azlan-works/Kestrel-15/README.md

# Kestrel-15: An Opensource FPGA SoM based on the Gowin GW5AT-15

1mm JLCPCB 6-layer 7628 stackup:
