azlan-works/Kestrel-15/Kestrel-15.kicad_pcb

## KiCad design Kestrel-15.kicad_pcb (2026-10-23)

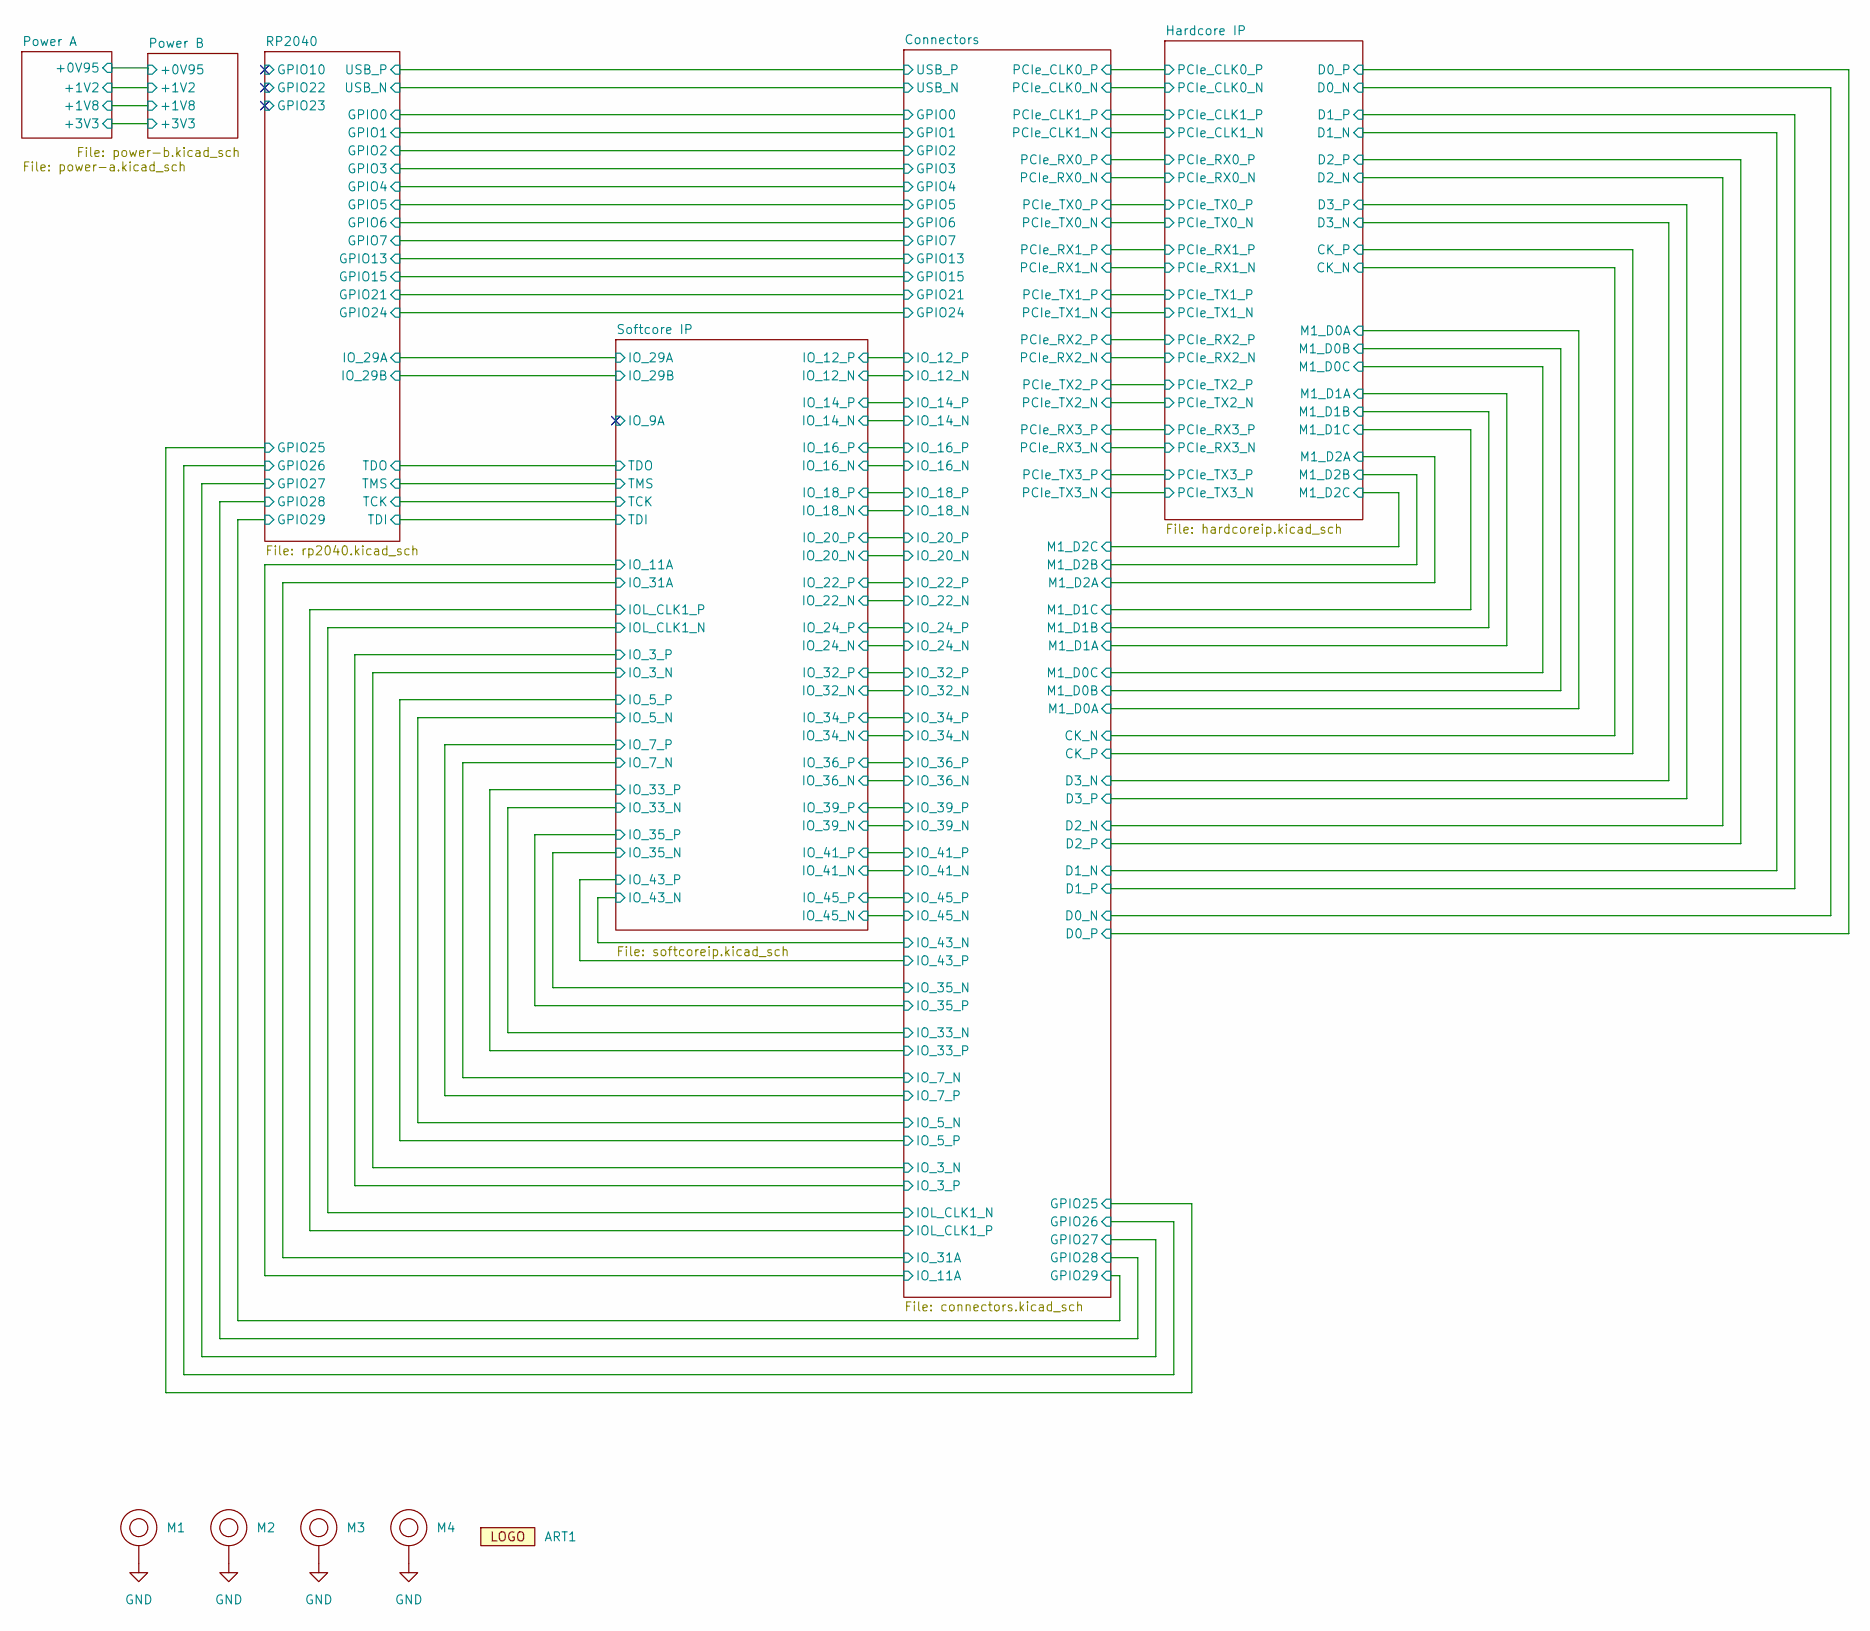
[picture p1: schematic Kestrel-15.kicad_sch]

Parts:
ART1: azlan.works_logo
M1, M2, M3, M4: M2_Hole

Connections:
GND: M1.1 (1_1), M2.1 (1_1), M3.1 (1_1), M4.1 (1_1); also elsewhere on the board

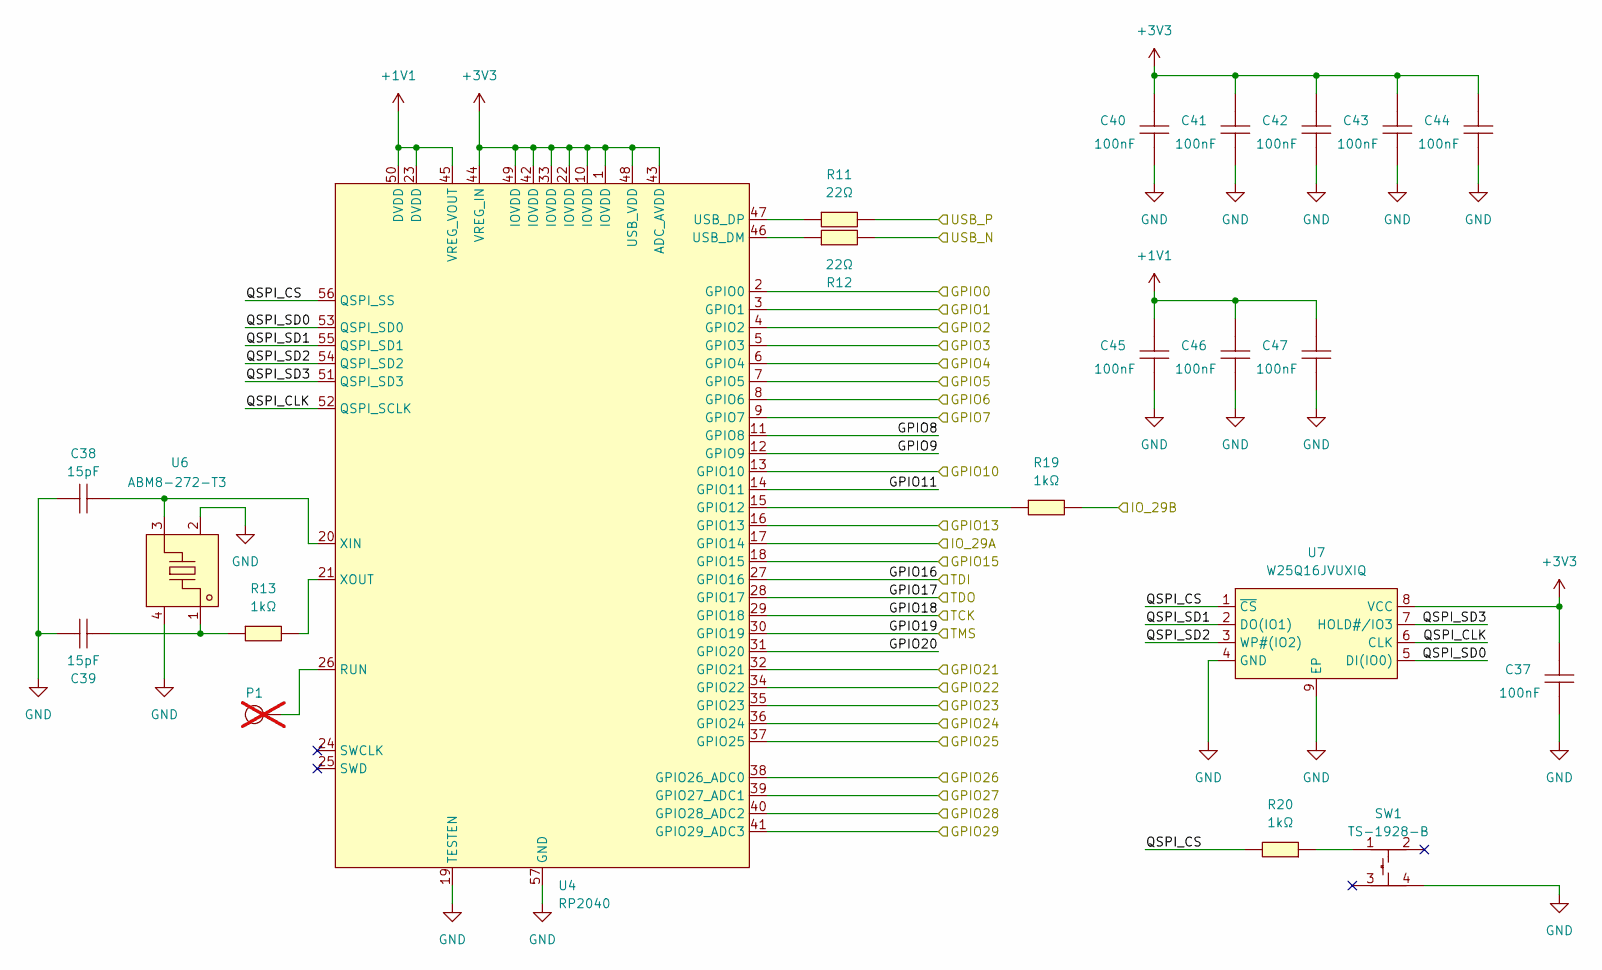
[picture p2: schematic rp2040.kicad_sch, Kestrel-15]

Parts:
C37, C40, C41, C42, C43, C44, C45, C46, C47: 100nF; C0201; MPN 0201X104M250NT; LCSC Part C52033358
C38, C39: 15pF; C0402; MPN 0402CG150J500NT; LCSC Part C1548
P1: Pogo Pin; TESTPOINT-SMD_BD2.0_C9900030651; MPN YTC1P-3010-01; LCSC Part C5221282; not fitted
R11, R12: 22Ω; R0402; MPN 0402WGF220JTCE; LCSC Part C25092
R13, R19, R20: 1kΩ; R0201; MPN 0201WMF1001TEE; LCSC Part C270365
SW1: TS-1928-B; KEY-SMD_4P-L2.8-W2.0-P1.20-LS3.0-TL; LCSC Part C1121891
U4: RP2040; LQFN-56_L7.0-W7.0-P0.4-EP; MPN RP2040; LCSC Part C2040
U6: ABM8-272-T3; CRYSTAL-SMD_4P-L3.2-W2.5-BL; MPN ABM8-272-T3; LCSC Part C20625731
U7: W25Q16JVUXIQ; USON-8_L3.0-W2.0-P0.50-BL-EP; MPN W25Q16JVUXIQ; LCSC Part C2843335

Connections:
+1V1: C45.2, C46.2, C47.2, U4.23 (DVDD), U4.45 (VREG_VOUT), U4.50 (DVDD)
+3V3: C37.2, C40.2, C41.2, C42.2, C43.2, C44.2, U4.1 (IOVDD), U4.10 (IOVDD), U4.22 (IOVDD), U4.33 (IOVDD), U4.42 (IOVDD), U4.43 (ADC_AVDD), U4.44 (VREG_IN), U4.48 (USB_VDD), U4.49 (IOVDD), U7.8 (VCC); also elsewhere on the board
/Connectors/GPIO0: U4.2 (GPIO0); also elsewhere on the board
/Connectors/GPIO1: U4.3 (GPIO1); also elsewhere on the board
/Connectors/GPIO2: U4.4 (GPIO2); also elsewhere on the board
/Connectors/GPIO3: U4.5 (GPIO3); also elsewhere on the board
/Connectors/GPIO4: U4.6 (GPIO4); also elsewhere on the board
/Connectors/GPIO5: U4.7 (GPIO5); also elsewhere on the board
/Connectors/GPIO6: U4.8 (GPIO6); also elsewhere on the board
/Connectors/GPIO7: U4.9 (GPIO7); also elsewhere on the board
/Connectors/GPIO13: U4.16 (GPIO13); also elsewhere on the board
/Connectors/GPIO15: U4.18 (GPIO15); also elsewhere on the board
/Connectors/GPIO21: U4.32 (GPIO21); also elsewhere on the board
/Connectors/GPIO24: U4.36 (GPIO24); also elsewhere on the board
/Connectors/GPIO25: U4.37 (GPIO25); also elsewhere on the board
/Connectors/GPIO26: U4.38 (GPIO26_ADC0); also elsewhere on the board
/Connectors/GPIO27: U4.39 (GPIO27_ADC1); also elsewhere on the board
/Connectors/GPIO28: U4.40 (GPIO28_ADC2); also elsewhere on the board
/Connectors/GPIO29: U4.41 (GPIO29_ADC3); also elsewhere on the board
/Connectors/USB_N: R12.2; also elsewhere on the board
/Connectors/USB_P: R11.2; also elsewhere on the board
/RP2040/GPIO8: U4.11 (GPIO8)
/RP2040/GPIO9: U4.12 (GPIO9)
/RP2040/GPIO10: U4.13 (GPIO10)
/RP2040/GPIO11: U4.14 (GPIO11)
/RP2040/GPIO16: U4.27 (GPIO16); also elsewhere on the board
/RP2040/GPIO17: U4.28 (GPIO17); also elsewhere on the board
/RP2040/GPIO18: U4.29 (GPIO18); also elsewhere on the board
/RP2040/GPIO19: U4.30 (GPIO19); also elsewhere on the board
/RP2040/GPIO20: U4.31 (GPIO20)
/RP2040/GPIO22: U4.34 (GPIO22)
/RP2040/GPIO23: U4.35 (GPIO23)
/RP2040/IO_29A: U4.17 (GPIO14); also elsewhere on the board
/RP2040/IO_29B: R19.2; also elsewhere on the board
/RP2040/QSPI_CLK: U4.52 (QSPI_SCLK), U7.6 (CLK)
/RP2040/QSPI_CS: R20.2, U4.56 (QSPI_SS), U7.1 (~CS)
/RP2040/QSPI_SD0: U4.53 (QSPI_SD0), U7.5 (DI(IO0))
/RP2040/QSPI_SD1: U4.55 (QSPI_SD1), U7.2 (DO(IO1))
/RP2040/QSPI_SD2: U4.54 (QSPI_SD2), U7.3 (WP#(IO2))
/RP2040/QSPI_SD3: U4.51 (QSPI_SD3), U7.7 (HOLD#/IO3)
GND: C37.1, C38.1, C39.1, C40.1, C41.1, C42.1, C43.1, C44.1, C45.1, C46.1, C47.1, SW1.4, U4.19 (TESTEN), U4.57 (GND), U6.2 (GND), U6.4 (GND), U7.4 (GND), U7.9 (EP); also elsewhere on the board
unnamed: C39.2, R13.1, U6.1
unnamed: R20.1, SW1.1
unnamed: R19.1, U4.15 (GPIO12)
unnamed: P1.1 (1_1), U4.26 (RUN)
unnamed: R12.1, U4.46 (USB_DM)
unnamed: R11.1, U4.47 (USB_DP)
unnamed: C38.2, U4.20 (XIN), U6.3
unnamed: R13.2, U4.21 (XOUT)

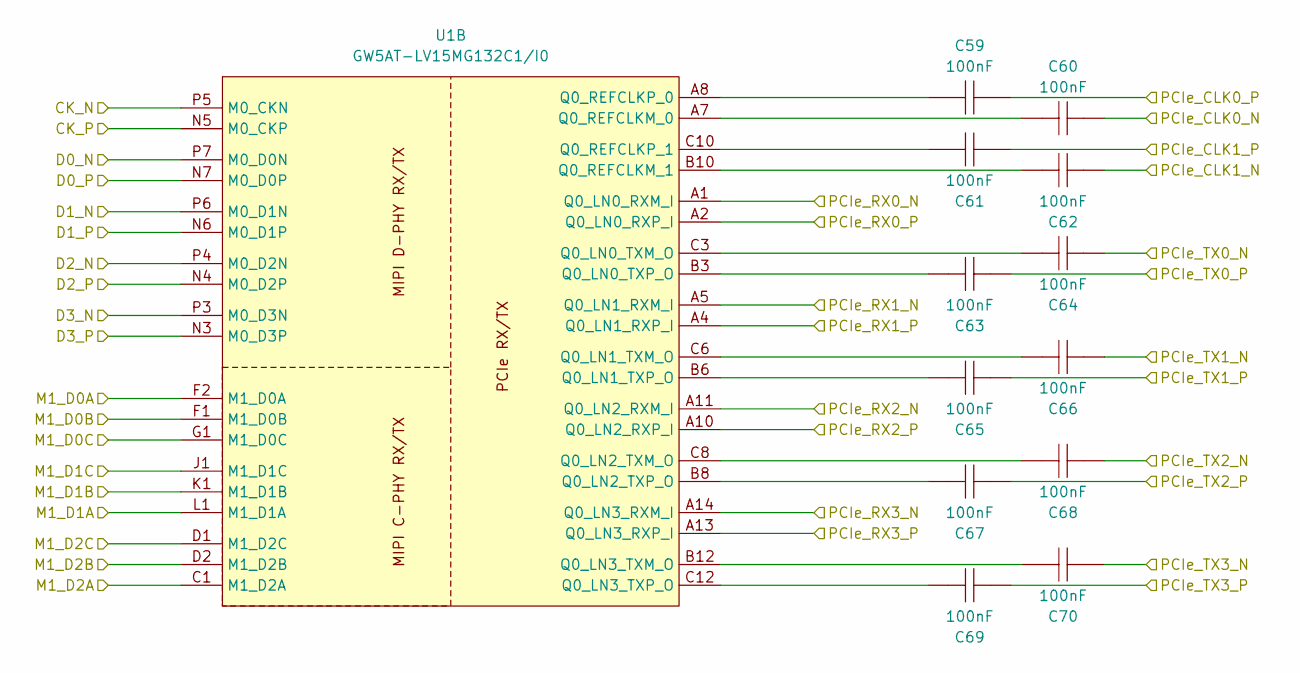
[picture p3: schematic hardcoreip.kicad_sch, Kestrel-15]

Parts:
C59, C60, C61, C62, C63, C64, C65, C66, C67, C68, C69, C70: 100nF; C0201; MPN 0201X104M250NT; LCSC Part C52033358
U1: GW5AT-LV15MG132C1/I0; CSBGA-132_L8.0-W8.0-P0.50-TL_GW1N-2K-MG132X1; MPN GW5AT-LV15MG132C1/I0; LCSC Part C54067362

Connections:
/Connectors/CK_N: U1.P5 (M0_CKN); also elsewhere on the board
/Connectors/CK_P: U1.N5 (M0_CKP); also elsewhere on the board
/Connectors/D0_N: U1.P7 (M0_D0N); also elsewhere on the board
/Connectors/D0_P: U1.N7 (M0_D0P); also elsewhere on the board
/Connectors/D1_N: U1.P6 (M0_D1N); also elsewhere on the board
/Connectors/D1_P: U1.N6 (M0_D1P); also elsewhere on the board
/Connectors/D2_N: U1.P4 (M0_D2N); also elsewhere on the board
/Connectors/D2_P: U1.N4 (M0_D2P); also elsewhere on the board
/Connectors/D3_N: U1.P3 (M0_D3N); also elsewhere on the board
/Connectors/D3_P: U1.N3 (M0_D3P); also elsewhere on the board
/Connectors/M1_D0A: U1.F2 (M1_D0A); also elsewhere on the board
/Connectors/M1_D0B: U1.F1 (M1_D0B); also elsewhere on the board
/Connectors/M1_D0C: U1.G1 (M1_D0C); also elsewhere on the board
/Connectors/M1_D1A: U1.L1 (M1_D1A); also elsewhere on the board
/Connectors/M1_D1B: U1.K1 (M1_D1B); also elsewhere on the board
/Connectors/M1_D1C: U1.J1 (M1_D1C); also elsewhere on the board
/Connectors/M1_D2A: U1.C1 (M1_D2A); also elsewhere on the board
/Connectors/M1_D2B: U1.D2 (M1_D2B); also elsewhere on the board
/Connectors/M1_D2C: U1.D1 (M1_D2C); also elsewhere on the board
/Connectors/PCIe_CLK0_N: C60.2; also elsewhere on the board
/Connectors/PCIe_CLK0_P: C59.2; also elsewhere on the board
/Connectors/PCIe_CLK1_N: C62.2; also elsewhere on the board
/Connectors/PCIe_CLK1_P: C61.2; also elsewhere on the board
/Connectors/PCIe_RX0_N: U1.A1 (Q0_LN0_RXM_I); also elsewhere on the board
/Connectors/PCIe_RX0_P: U1.A2 (Q0_LN0_RXP_I); also elsewhere on the board
/Connectors/PCIe_RX1_N: U1.A5 (Q0_LN1_RXM_I); also elsewhere on the board
/Connectors/PCIe_RX1_P: U1.A4 (Q0_LN1_RXP_I); also elsewhere on the board
/Connectors/PCIe_RX2_N: U1.A11 (Q0_LN2_RXM_I); also elsewhere on the board
/Connectors/PCIe_RX2_P: U1.A10 (Q0_LN2_RXP_I); also elsewhere on the board
/Connectors/PCIe_RX3_N: U1.A14 (Q0_LN3_RXM_I); also elsewhere on the board
/Connectors/PCIe_RX3_P: U1.A13 (Q0_LN3_RXP_I); also elsewhere on the board
/Connectors/PCIe_TX0_N: C64.2; also elsewhere on the board
/Connectors/PCIe_TX0_P: C63.2; also elsewhere on the board
/Connectors/PCIe_TX1_N: C66.2; also elsewhere on the board
/Connectors/PCIe_TX1_P: C65.2; also elsewhere on the board
/Connectors/PCIe_TX2_N: C68.2; also elsewhere on the board
/Connectors/PCIe_TX2_P: C67.2; also elsewhere on the board
/Connectors/PCIe_TX3_N: C70.2; also elsewhere on the board
/Connectors/PCIe_TX3_P: C69.2; also elsewhere on the board
unnamed: C64.1, U1.C3 (Q0_LN0_TXM_O)
unnamed: C63.1, U1.B3 (Q0_LN0_TXP_O)
unnamed: C66.1, U1.C6 (Q0_LN1_TXM_O)
unnamed: C65.1, U1.B6 (Q0_LN1_TXP_O)
unnamed: C68.1, U1.C8 (Q0_LN2_TXM_O)
unnamed: C67.1, U1.B8 (Q0_LN2_TXP_O)
unnamed: C70.1, U1.B12 (Q0_LN3_TXM_O)
unnamed: C69.1, U1.C12 (Q0_LN3_TXP_O)
unnamed: C60.1, U1.A7 (Q0_REFCLKM_0)
unnamed: C62.1, U1.B10 (Q0_REFCLKM_1)
unnamed: C59.1, U1.A8 (Q0_REFCLKP_0)
unnamed: C61.1, U1.C10 (Q0_REFCLKP_1)

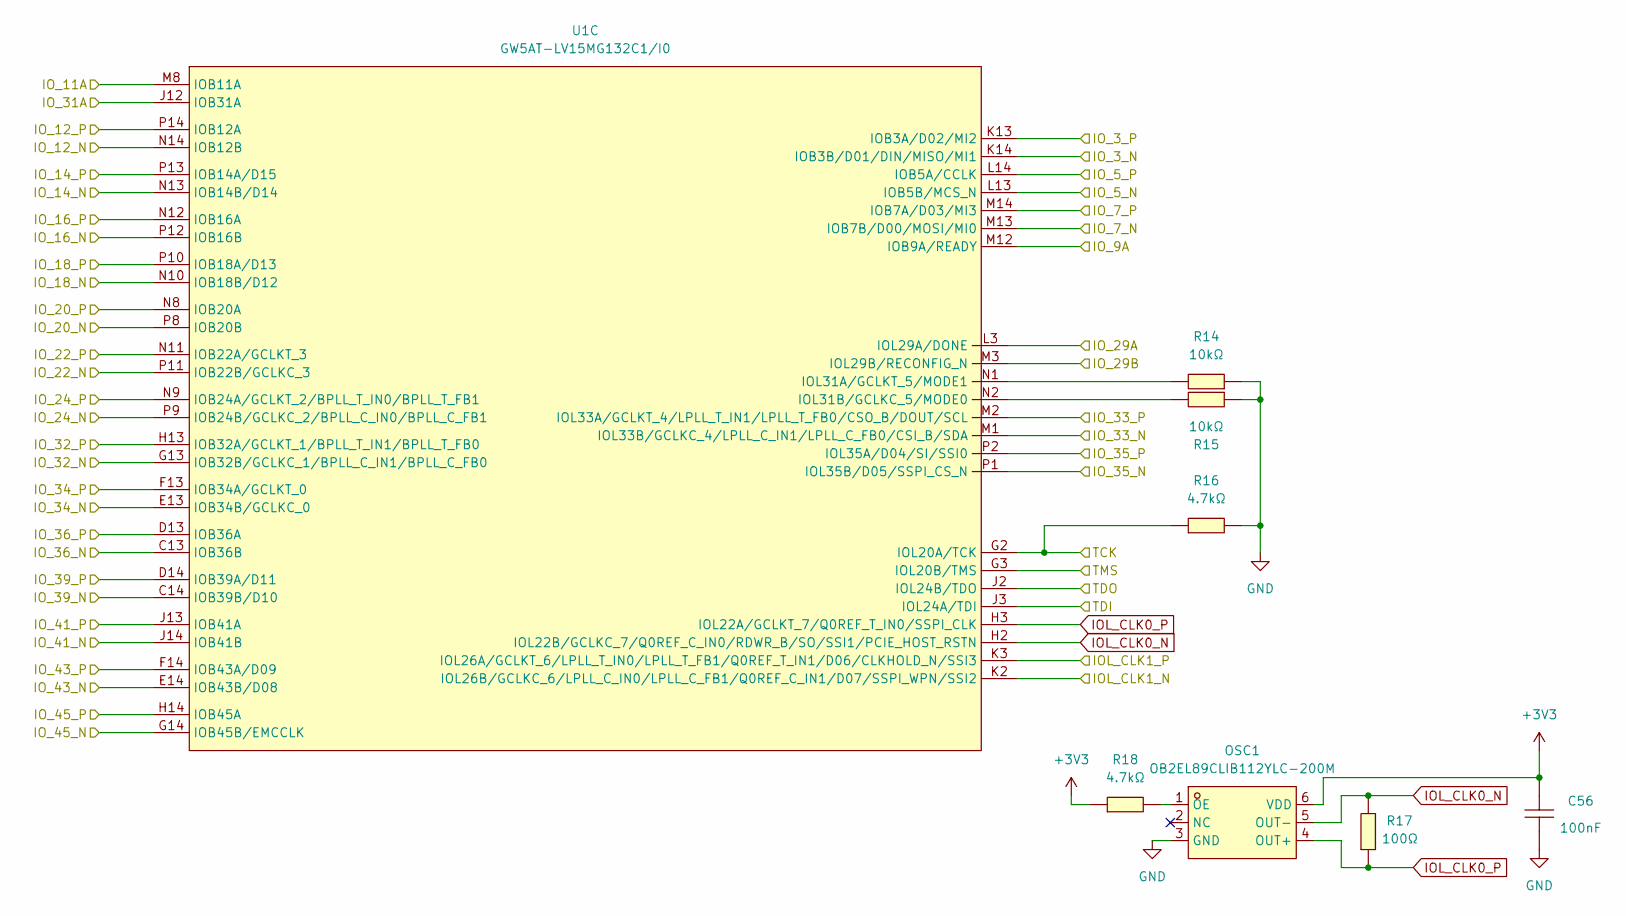
[picture p4: schematic softcoreip.kicad_sch, Kestrel-15]

Parts:
C56: 100nF; C0201; MPN 0201X104M250NT; LCSC Part C52033358
OSC1: OB2EL89CLIB112YLC-200M; OSC-SMD_6P-L3.2-W2.5-BL-1; MPN OB2EL89CLIB112YLC-200M; LCSC Part C41371042
R14, R15: 10kΩ; R0402; MPN 0402WGF1002TCE; LCSC Part C25744
R16, R18: 4.7kΩ; R0402; MPN 0402WGF4701TCE; LCSC Part C25900
R17: 100Ω; R0402; MPN 0402WGF1000TCE; LCSC Part C25076
U1: GW5AT-LV15MG132C1/I0; CSBGA-132_L8.0-W8.0-P0.50-TL_GW1N-2K-MG132X1; MPN GW5AT-LV15MG132C1/I0; LCSC Part C54067362

Connections:
+3V3: C56.2, OSC1.6 (VDD), R18.1; also elsewhere on the board
/Connectors/IOL_CLK1_N: U1.K2 (IOL26B/GCLKC_6/LPLL_C_IN0/LPLL_C_FB1/Q0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); also elsewhere on the board
/Connectors/IOL_CLK1_P: U1.K3 (IOL26A/GCLKT_6/LPLL_T_IN0/LPLL_T_FB1/Q0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); also elsewhere on the board
/Connectors/IO_3_N: U1.K14 (IOB3B/D01/DIN/MISO/MI1); also elsewhere on the board
/Connectors/IO_3_P: U1.K13 (IOB3A/D02/MI2); also elsewhere on the board
/Connectors/IO_5_N: U1.L13 (IOB5B/MCS_N); also elsewhere on the board
/Connectors/IO_5_P: U1.L14 (IOB5A/CCLK); also elsewhere on the board
/Connectors/IO_7_N: U1.M13 (IOB7B/D00/MOSI/MI0); also elsewhere on the board
/Connectors/IO_7_P: U1.M14 (IOB7A/D03/MI3); also elsewhere on the board
/Connectors/IO_11A: U1.M8 (IOB11A); also elsewhere on the board
/Connectors/IO_12_N: U1.N14 (IOB12B); also elsewhere on the board
/Connectors/IO_12_P: U1.P14 (IOB12A); also elsewhere on the board
/Connectors/IO_14_N: U1.N13 (IOB14B/D14); also elsewhere on the board
/Connectors/IO_14_P: U1.P13 (IOB14A/D15); also elsewhere on the board
/Connectors/IO_16_N: U1.P12 (IOB16B); also elsewhere on the board
/Connectors/IO_16_P: U1.N12 (IOB16A); also elsewhere on the board
/Connectors/IO_18_N: U1.N10 (IOB18B/D12); also elsewhere on the board
/Connectors/IO_18_P: U1.P10 (IOB18A/D13); also elsewhere on the board
/Connectors/IO_20_N: U1.P8 (IOB20B); also elsewhere on the board
/Connectors/IO_20_P: U1.N8 (IOB20A); also elsewhere on the board
/Connectors/IO_22_N: U1.P11 (IOB22B/GCLKC_3); also elsewhere on the board
/Connectors/IO_22_P: U1.N11 (IOB22A/GCLKT_3); also elsewhere on the board
/Connectors/IO_24_N: U1.P9 (IOB24B/GCLKC_2/BPLL_C_IN0/BPLL_C_FB1); also elsewhere on the board
/Connectors/IO_24_P: U1.N9 (IOB24A/GCLKT_2/BPLL_T_IN0/BPLL_T_FB1); also elsewhere on the board
/Connectors/IO_31A: U1.J12 (IOB31A); also elsewhere on the board
/Connectors/IO_32_N: U1.G13 (IOB32B/GCLKC_1/BPLL_C_IN1/BPLL_C_FB0); also elsewhere on the board
/Connectors/IO_32_P: U1.H13 (IOB32A/GCLKT_1/BPLL_T_IN1/BPLL_T_FB0); also elsewhere on the board
/Connectors/IO_33_N: U1.M1 (IOL33B/GCLKC_4/LPLL_C_IN1/LPLL_C_FB0/CS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); also elsewhere on the board
/Connectors/IO_33_P: U1.M2 (IOL33A/GCLKT_4/LPLL_T_IN1/LPLL_T_FB0/CS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); also elsewhere on the board
/Connectors/IO_34_N: U1.E13 (IOB34B/GCLKC_0); also elsewhere on the board
/Connectors/IO_34_P: U1.F13 (IOB34A/GCLKT_0); also elsewhere on the board
/Connectors/IO_35_N: U1.P1 (IOL35B/D05/SSPI_CS_N); also elsewhere on the board
/Connectors/IO_35_P: U1.P2 (IOL35A/D04/SI/SSI0); also elsewhere on the board
/Connectors/IO_36_N: U1.C13 (IOB36B); also elsewhere on the board
/Connectors/IO_36_P: U1.D13 (IOB36A); also elsewhere on the board
/Connectors/IO_39_N: U1.C14 (IOB39B/D10); also elsewhere on the board
/Connectors/IO_39_P: U1.D14 (IOB39A/D11); also elsewhere on the board
/Connectors/IO_41_N: U1.J14 (IOB41B); also elsewhere on the board
/Connectors/IO_41_P: U1.J13 (IOB41A); also elsewhere on the board
/Connectors/IO_43_N: U1.E14 (IOB43B/D08); also elsewhere on the board
/Connectors/IO_43_P: U1.F14 (IOB43A/D09); also elsewhere on the board
/Connectors/IO_45_N: U1.G14 (IOB45B/EMCCLK); also elsewhere on the board
/Connectors/IO_45_P: U1.H14 (IOB45A); also elsewhere on the board
/RP2040/GPIO16: U1.J3 (IOL24A/TDI); also elsewhere on the board
/RP2040/GPIO17: U1.J2 (IOL24B/TDO); also elsewhere on the board
/RP2040/GPIO18: R16.1, U1.G2 (IOL20A/TCK); also elsewhere on the board
/RP2040/GPIO19: U1.G3 (IOL20B/TMS); also elsewhere on the board
/RP2040/IO_29A: U1.L3 (IOL29A/DONE); also elsewhere on the board
/RP2040/IO_29B: U1.M3 (IOL29B/RECONFIG_N); also elsewhere on the board
/Softcore IP/IO_9A: U1.M12 (IOB9A/READY)
GND: C56.1, OSC1.3 (GND), R14.1, R15.1, R16.2; also elsewhere on the board
IOL_CLK0_N: OSC1.5 (OUT-), R17.2, U1.H2 (IOL22B/GCLKC_7/Q0REF_C_IN0/RDWR_B/SO/SS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)
IOL_CLK0_P: OSC1.4 (OUT+), R17.1, U1.H3 (IOL22A/GCLKT_7/Q0REF_T_IN0/SSPI_CLK)
unnamed: OSC1.1 (OE), R18.2
unnamed: R14.2, U1.N1 (IOL31A/GCLKT_5/MODE1)
unnamed: R15.2, U1.N2 (IOL31B/GCLKC_5/MODE0)

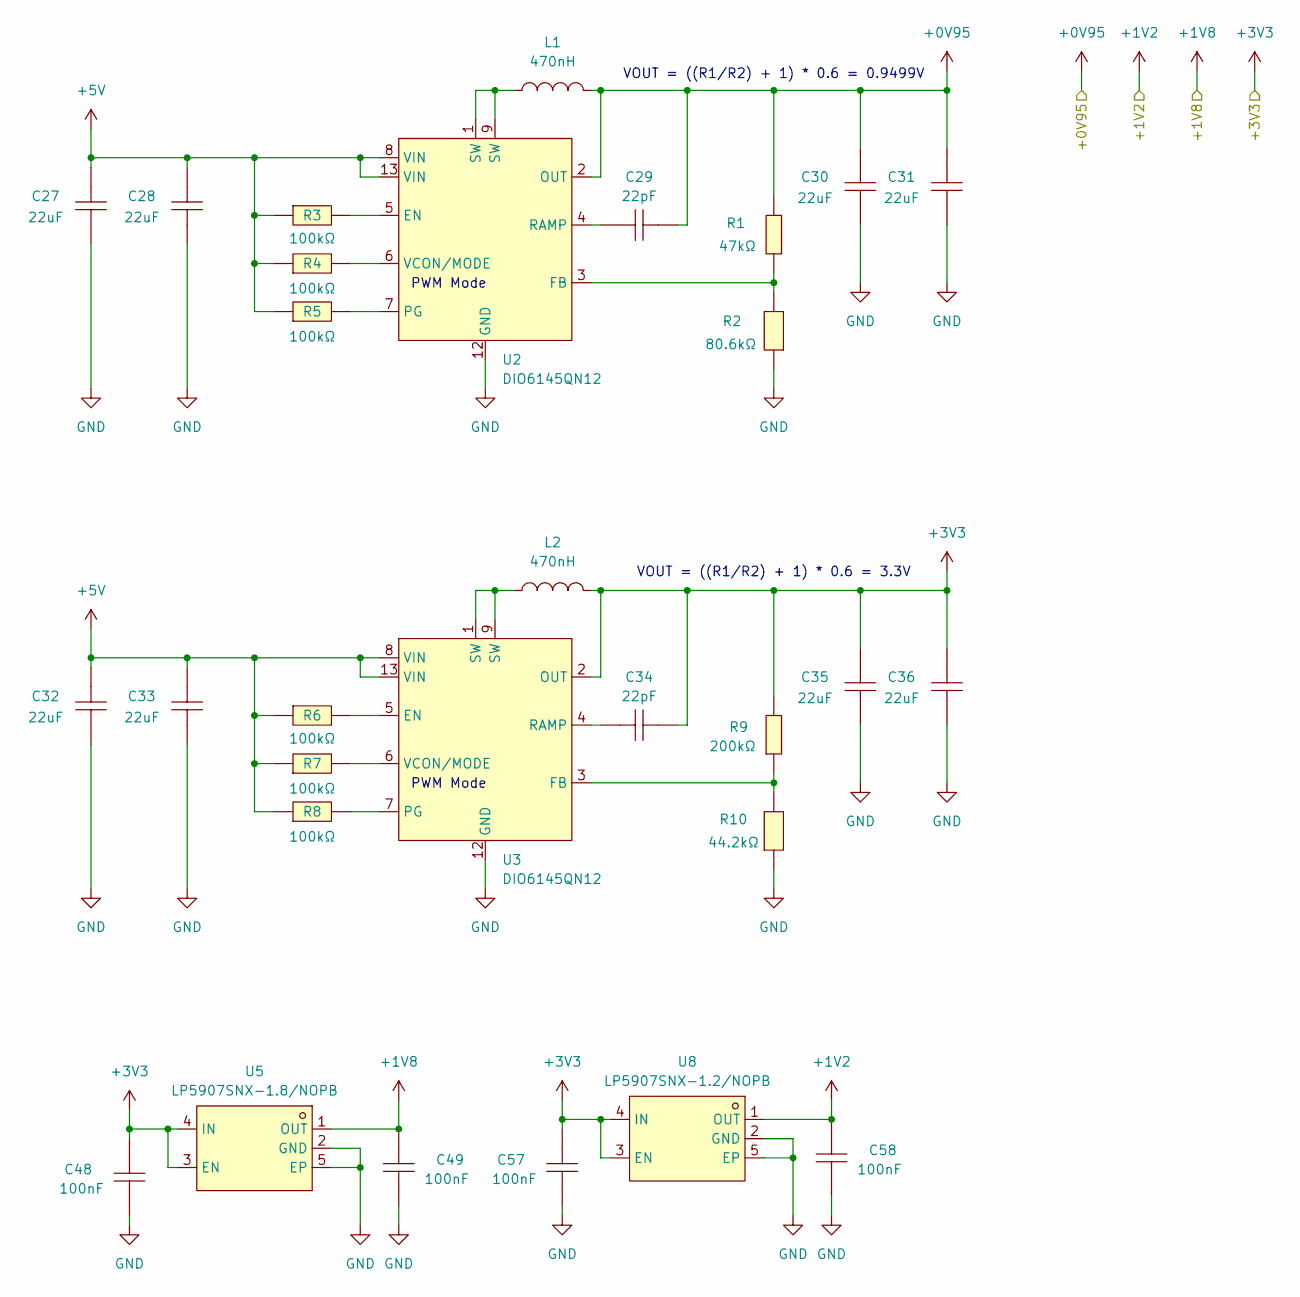
[picture p5: schematic power-b.kicad_sch, Kestrel-15]

Parts:
C27, C28, C30, C31, C32, C33, C35, C36: 22uF; C0603; MPN CL10A226MQ8NRNC; LCSC Part C59461
C29, C34: 22pF; C0201; MPN C0603C0G1H220JT00NN; LCSC Part C49296932
C48, C49, C57, C58: 100nF; C0201; MPN 0201X104M250NT; LCSC Part C52033358
L1, L2: 470nH; IND-SMD_L2.5-W2.0_FTC252010S; MPN FTC252010SR47MBCA; LCSC Part C5832354
R1: 47kΩ; R0201; MPN PF01WMF4702TEE; LCSC Part C50670294
R2: 80.6kΩ; R0201; MPN NQ01WMF8062TEE; LCSC Part C50670129
R3, R4, R5, R6, R7, R8: 100kΩ; R0201; MPN PF01WMF1003TEE; LCSC Part C50670353
R9: 200kΩ; R0201; MPN 0201WMF2003TEE; LCSC Part C270357
R10: 44.2kΩ; R0201; MPN GR0201F44K2TAG00; LCSC Part C49655072
U2, U3: DIO6145QN12; QFN-12_L3.0-W2.0-P0.50_DIO6145QN12; MPN DIO6145QN12; LCSC Part C2980987
U5: LP5907SNX-1.8/NOPB; ZQFN-4L_L1.0-W1.0-P0.63-BL-EP; MPN LP5907SNX-1.8/NOPB; LCSC Part C139378
U8: LP5907SNX-1.2/NOPB; ZQFN-4L_L1.0-W1.0-P0.63-BL-EP; MPN LP5907SNX-1.2/NOPB; LCSC Part C165128

Connections:
+0V95: C29.2, C30.2, C31.2, L1.2, R1.2, U2.2 (OUT); also elsewhere on the board
+1V2: C58.2, U8.1 (OUT); also elsewhere on the board
+1V8: C49.2, U5.1 (OUT); also elsewhere on the board
+3V3: C34.2, C35.2, C36.2, C48.2, C57.2, L2.2, R9.2, U3.2 (OUT), U5.3 (EN), U5.4 (IN), U8.3 (EN), U8.4 (IN); also elsewhere on the board
+5V: C27.2, C28.2, C32.2, C33.2, R3.1, R4.1, R5.1, R6.1, R7.1, R8.1, U2.8 (VIN), U2.13 (VIN), U3.8 (VIN), U3.13 (VIN); also elsewhere on the board
GND: C27.1, C28.1, C30.1, C31.1, C32.1, C33.1, C35.1, C36.1, C48.1, C49.1, C57.1, C58.1, R2.1, R10.1, U2.12 (GND), U3.12 (GND), U5.2 (GND), U5.5 (EP), U8.2 (GND), U8.5 (EP); also elsewhere on the board
unnamed: L1.1, U2.1 (SW), U2.9 (SW)
unnamed: L2.1, U3.1 (SW), U3.9 (SW)
unnamed: R3.2, U2.5 (EN)
unnamed: R1.1, R2.2, U2.3 (FB)
unnamed: R5.2, U2.7 (PG)
unnamed: C29.1, U2.4 (RAMP)
unnamed: R4.2, U2.6 (VCON/MODE)
unnamed: R6.2, U3.5 (EN)
unnamed: R9.1, R10.2, U3.3 (FB)
unnamed: R8.2, U3.7 (PG)
unnamed: C34.1, U3.4 (RAMP)
unnamed: R7.2, U3.6 (VCON/MODE)

Notes on the sheet:
VOUT = ((R1/R2) + 1) * 0.6 = 3.3V
PWM Mode
VOUT = ((R1/R2) + 1) * 0.6 = 0.9499V

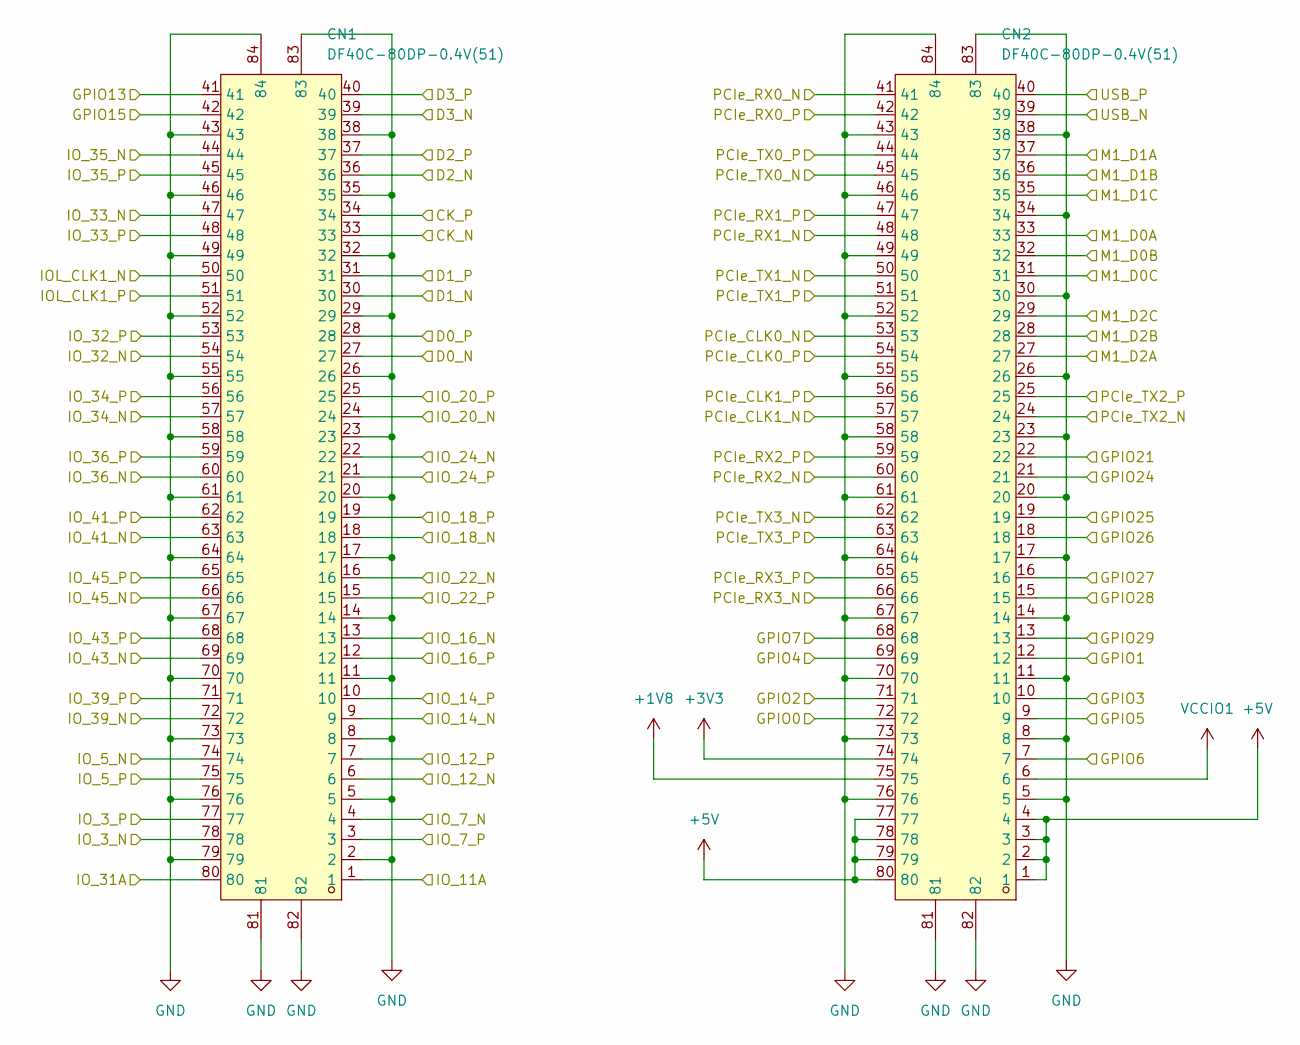
[picture p6: schematic connectors.kicad_sch, Kestrel-15]

Parts:
CN1, CN2: DF40C-80DP-0.4V(51); CONN-SMD_DF40C-80DP-0.4V-51; MPN DF40C-80DP-0.4V(51); LCSC Part C294544

Connections:
+1V8: CN2.75; also elsewhere on the board
+3V3: CN2.74; also elsewhere on the board
+5V: CN2.1, CN2.2, CN2.3, CN2.4, CN2.77, CN2.78, CN2.79, CN2.80; also elsewhere on the board
/Connectors/CK_N: CN1.33; also elsewhere on the board
/Connectors/CK_P: CN1.34; also elsewhere on the board
/Connectors/D0_N: CN1.27; also elsewhere on the board
/Connectors/D0_P: CN1.28; also elsewhere on the board
/Connectors/D1_N: CN1.30; also elsewhere on the board
/Connectors/D1_P: CN1.31; also elsewhere on the board
/Connectors/D2_N: CN1.36; also elsewhere on the board
/Connectors/D2_P: CN1.37; also elsewhere on the board
/Connectors/D3_N: CN1.39; also elsewhere on the board
/Connectors/D3_P: CN1.40; also elsewhere on the board
/Connectors/GPIO0: CN2.72; also elsewhere on the board
/Connectors/GPIO1: CN2.12; also elsewhere on the board
/Connectors/GPIO2: CN2.71; also elsewhere on the board
/Connectors/GPIO3: CN2.10; also elsewhere on the board
/Connectors/GPIO4: CN2.69; also elsewhere on the board
/Connectors/GPIO5: CN2.9; also elsewhere on the board
/Connectors/GPIO6: CN2.7; also elsewhere on the board
/Connectors/GPIO7: CN2.68; also elsewhere on the board
/Connectors/GPIO13: CN1.41; also elsewhere on the board
/Connectors/GPIO15: CN1.42; also elsewhere on the board
/Connectors/GPIO21: CN2.22; also elsewhere on the board
/Connectors/GPIO24: CN2.21; also elsewhere on the board
/Connectors/GPIO25: CN2.19; also elsewhere on the board
/Connectors/GPIO26: CN2.18; also elsewhere on the board
/Connectors/GPIO27: CN2.16; also elsewhere on the board
/Connectors/GPIO28: CN2.15; also elsewhere on the board
/Connectors/GPIO29: CN2.13; also elsewhere on the board
/Connectors/IOL_CLK1_N: CN1.50; also elsewhere on the board
/Connectors/IOL_CLK1_P: CN1.51; also elsewhere on the board
/Connectors/IO_3_N: CN1.78; also elsewhere on the board
/Connectors/IO_3_P: CN1.77; also elsewhere on the board
/Connectors/IO_5_N: CN1.74; also elsewhere on the board
/Connectors/IO_5_P: CN1.75; also elsewhere on the board
/Connectors/IO_7_N: CN1.4; also elsewhere on the board
/Connectors/IO_7_P: CN1.3; also elsewhere on the board
/Connectors/IO_11A: CN1.1; also elsewhere on the board
/Connectors/IO_12_N: CN1.6; also elsewhere on the board
/Connectors/IO_12_P: CN1.7; also elsewhere on the board
/Connectors/IO_14_N: CN1.9; also elsewhere on the board
/Connectors/IO_14_P: CN1.10; also elsewhere on the board
/Connectors/IO_16_N: CN1.13; also elsewhere on the board
/Connectors/IO_16_P: CN1.12; also elsewhere on the board
/Connectors/IO_18_N: CN1.18; also elsewhere on the board
/Connectors/IO_18_P: CN1.19; also elsewhere on the board
/Connectors/IO_20_N: CN1.24; also elsewhere on the board
/Connectors/IO_20_P: CN1.25; also elsewhere on the board
/Connectors/IO_22_N: CN1.16; also elsewhere on the board
/Connectors/IO_22_P: CN1.15; also elsewhere on the board
/Connectors/IO_24_N: CN1.22; also elsewhere on the board
/Connectors/IO_24_P: CN1.21; also elsewhere on the board
/Connectors/IO_31A: CN1.80; also elsewhere on the board
/Connectors/IO_32_N: CN1.54; also elsewhere on the board
/Connectors/IO_32_P: CN1.53; also elsewhere on the board
/Connectors/IO_33_N: CN1.47; also elsewhere on the board
/Connectors/IO_33_P: CN1.48; also elsewhere on the board
/Connectors/IO_34_N: CN1.57; also elsewhere on the board
/Connectors/IO_34_P: CN1.56; also elsewhere on the board
/Connectors/IO_35_N: CN1.44; also elsewhere on the board
/Connectors/IO_35_P: CN1.45; also elsewhere on the board
/Connectors/IO_36_N: CN1.60; also elsewhere on the board
/Connectors/IO_36_P: CN1.59; also elsewhere on the board
/Connectors/IO_39_N: CN1.72; also elsewhere on the board
/Connectors/IO_39_P: CN1.71; also elsewhere on the board
/Connectors/IO_41_N: CN1.63; also elsewhere on the board
/Connectors/IO_41_P: CN1.62; also elsewhere on the board
/Connectors/IO_43_N: CN1.69; also elsewhere on the board
/Connectors/IO_43_P: CN1.68; also elsewhere on the board
/Connectors/IO_45_N: CN1.66; also elsewhere on the board
/Connectors/IO_45_P: CN1.65; also elsewhere on the board
/Connectors/M1_D0A: CN2.33; also elsewhere on the board
/Connectors/M1_D0B: CN2.32; also elsewhere on the board
/Connectors/M1_D0C: CN2.31; also elsewhere on the board
/Connectors/M1_D1A: CN2.37; also elsewhere on the board
/Connectors/M1_D1B: CN2.36; also elsewhere on the board
/Connectors/M1_D1C: CN2.35; also elsewhere on the board
/Connectors/M1_D2A: CN2.27; also elsewhere on the board
/Connectors/M1_D2B: CN2.28; also elsewhere on the board
/Connectors/M1_D2C: CN2.29; also elsewhere on the board
/Connectors/PCIe_CLK0_N: CN2.53; also elsewhere on the board
/Connectors/PCIe_CLK0_P: CN2.54; also elsewhere on the board
/Connectors/PCIe_CLK1_N: CN2.57; also elsewhere on the board
/Connectors/PCIe_CLK1_P: CN2.56; also elsewhere on the board
/Connectors/PCIe_RX0_N: CN2.41; also elsewhere on the board
/Connectors/PCIe_RX0_P: CN2.42; also elsewhere on the board
/Connectors/PCIe_RX1_N: CN2.48; also elsewhere on the board
/Connectors/PCIe_RX1_P: CN2.47; also elsewhere on the board
/Connectors/PCIe_RX2_N: CN2.60; also elsewhere on the board
/Connectors/PCIe_RX2_P: CN2.59; also elsewhere on the board
/Connectors/PCIe_RX3_N: CN2.66; also elsewhere on the board
/Connectors/PCIe_RX3_P: CN2.65; also elsewhere on the board
/Connectors/PCIe_TX0_N: CN2.45; also elsewhere on the board
/Connectors/PCIe_TX0_P: CN2.44; also elsewhere on the board
/Connectors/PCIe_TX1_N: CN2.50; also elsewhere on the board
/Connectors/PCIe_TX1_P: CN2.51; also elsewhere on the board
/Connectors/PCIe_TX2_N: CN2.24; also elsewhere on the board
/Connectors/PCIe_TX2_P: CN2.25; also elsewhere on the board
/Connectors/PCIe_TX3_N: CN2.62; also elsewhere on the board
/Connectors/PCIe_TX3_P: CN2.63; also elsewhere on the board
/Connectors/USB_N: CN2.39; also elsewhere on the board
/Connectors/USB_P: CN2.40; also elsewhere on the board
GND: CN1.2, CN1.5, CN1.8, CN1.11, CN1.14, CN1.17, CN1.20, CN1.23, CN1.26, CN1.29, CN1.32, CN1.35, CN1.38, CN1.43, CN1.46, CN1.49, CN1.52, CN1.55, CN1.58, CN1.61, CN1.64, CN1.67, CN1.70, CN1.73, CN1.76, CN1.79, CN1.81, CN1.82, CN1.83, CN1.84, CN2.5, CN2.8, CN2.11, CN2.14, CN2.17, CN2.20, CN2.23, CN2.26, CN2.30, CN2.34, CN2.38, CN2.43, CN2.46, CN2.49, CN2.52, CN2.55, CN2.58, CN2.61, CN2.64, CN2.67, CN2.70, CN2.73, CN2.76, CN2.81, CN2.82, CN2.83, CN2.84; also elsewhere on the board
VCCIO1: CN2.6; also elsewhere on the board
