azlan-works/Kestrel-15/Kestrel-15.kicad_pcb

## KiCad design Kestrel-15.kicad_pcb (continued)

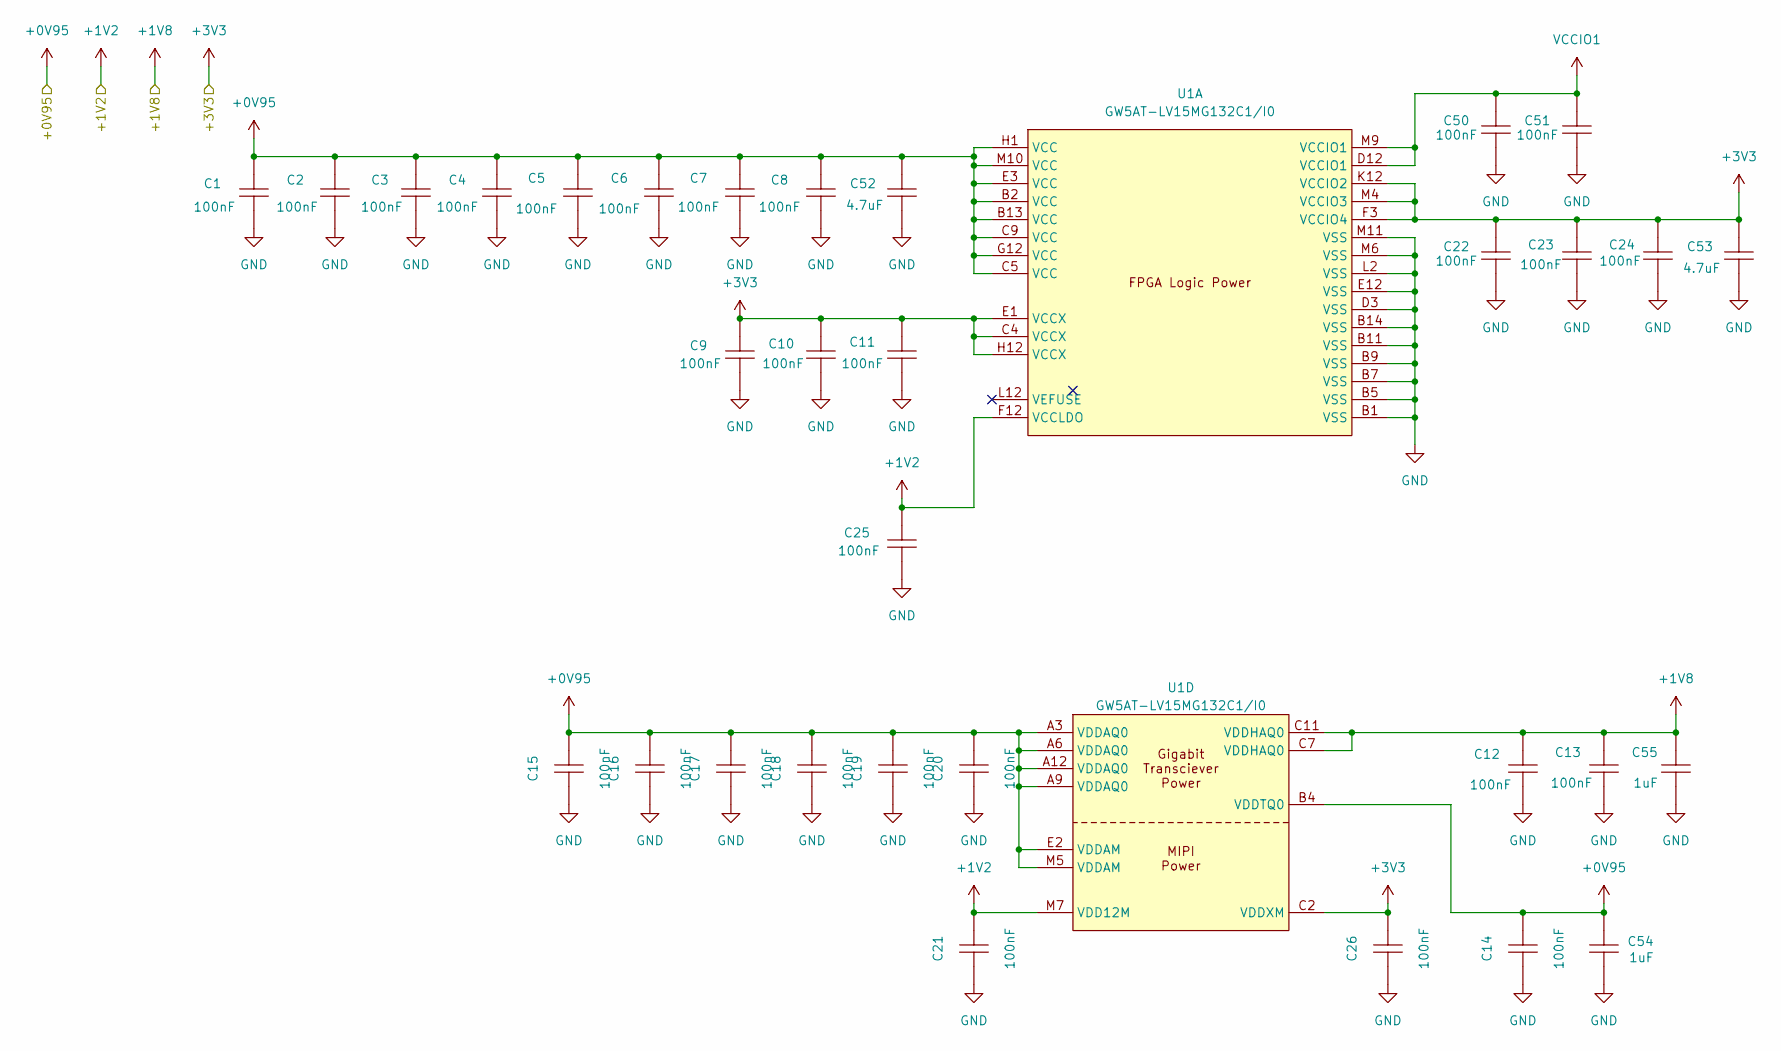
[picture p7: schematic power-a.kicad_sch, Kestrel-15]

Parts:
C1, C2, C3, C4, C5, C6, C7, C8, C9, C10, C11, C12, C13, C14, C15, C16, C17, C18, C19, C20, C21, C22, C23, C24, C25, C26, C50, C51: 100nF; C0201; MPN 0201X104M250NT; LCSC Part C52033358
C52, C53: 4.7uF; C0402; MPN CL05A475MP5NRNC; LCSC Part C23733
C54, C55: 1uF; C0402; MPN CL05A105KA5NQNC; LCSC Part C52923
U1: GW5AT-LV15MG132C1/I0; CSBGA-132_L8.0-W8.0-P0.50-TL_GW1N-2K-MG132X1; MPN GW5AT-LV15MG132C1/I0; LCSC Part C54067362

Connections:
+0V95: C1.2, C2.2, C3.2, C4.2, C5.2, C6.2, C7.2, C8.2, C14.2, C15.2, C16.2, C17.2, C18.2, C19.2, C20.2, C52.2, C54.2, U1.A3 (VDDAQ0), U1.A6 (VDDAQ0), U1.A9 (VDDAQ0), U1.A12 (VDDAQ0), U1.B2 (VCC), U1.B4 (VDDTQ0), U1.B13 (VCC), U1.C5 (VCC), U1.C9 (VCC), U1.E2 (VDDAM), U1.E3 (VCC), U1.G12 (VCC), U1.H1 (VCC), U1.M5 (VDDAM), U1.M10 (VCC); also elsewhere on the board
+1V2: C21.2, C25.2, U1.F12 (VCCLDO), U1.M7 (VDD12M); also elsewhere on the board
+1V8: C12.2, C13.2, C55.2, U1.C7 (VDDHAQ0), U1.C11 (VDDHAQ0); also elsewhere on the board
+3V3: C9.2, C10.2, C11.2, C22.2, C23.2, C24.2, C26.2, C53.2, U1.C2 (VDDXM), U1.C4 (VCCX), U1.E1 (VCCX), U1.F3 (VCCIO4), U1.H12 (VCCX), U1.K12 (VCCIO2), U1.M4 (VCCIO3); also elsewhere on the board
GND: C1.1, C2.1, C3.1, C4.1, C5.1, C6.1, C7.1, C8.1, C9.1, C10.1, C11.1, C12.1, C13.1, C14.1, C15.1, C16.1, C17.1, C18.1, C19.1, C20.1, C21.1, C22.1, C23.1, C24.1, C25.1, C26.1, C50.1, C51.1, C52.1, C53.1, C54.1, C55.1, U1.B1 (VSS), U1.B5 (VSS), U1.B7 (VSS), U1.B9 (VSS), U1.B11 (VSS), U1.B14 (VSS), U1.D3 (VSS), U1.E12 (VSS), U1.L2 (VSS), U1.M6 (VSS), U1.M11 (VSS); also elsewhere on the board
VCCIO1: C50.2, C51.2, U1.D12 (VCCIO1), U1.M9 (VCCIO1); also elsewhere on the board

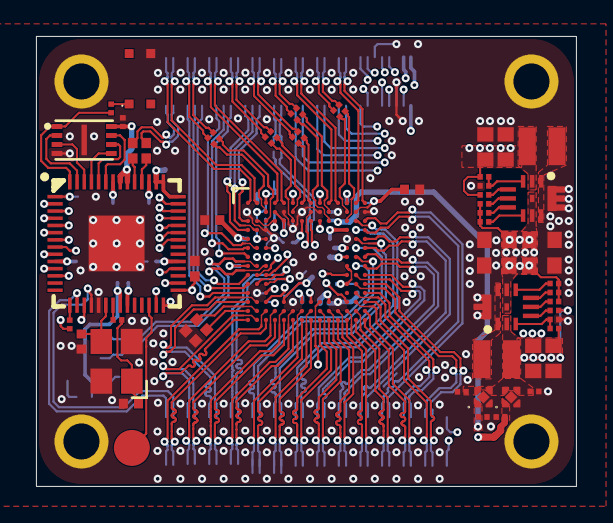
[picture p8: board Kestrel-15.kicad_pcb from above]

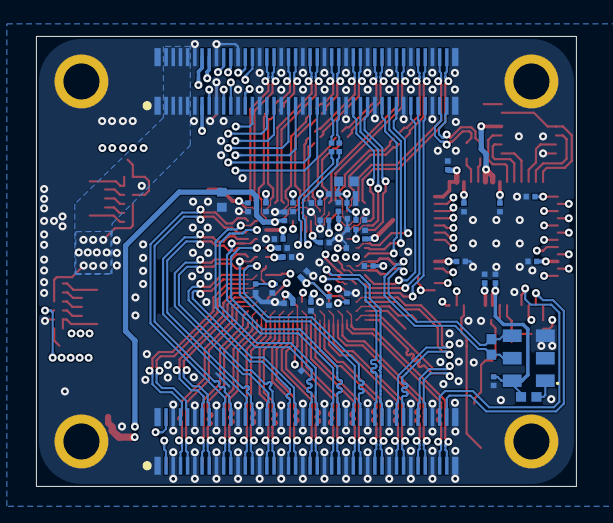
[picture p9: board Kestrel-15.kicad_pcb from below]

Board: 6 copper layers, 30.0 x 25.0 mm, 110 parts (46 on the bottom side), 157 nets.
